sinara-hw/HVSUP_ISOL/MECH/coil_cover/coil_cover.stp

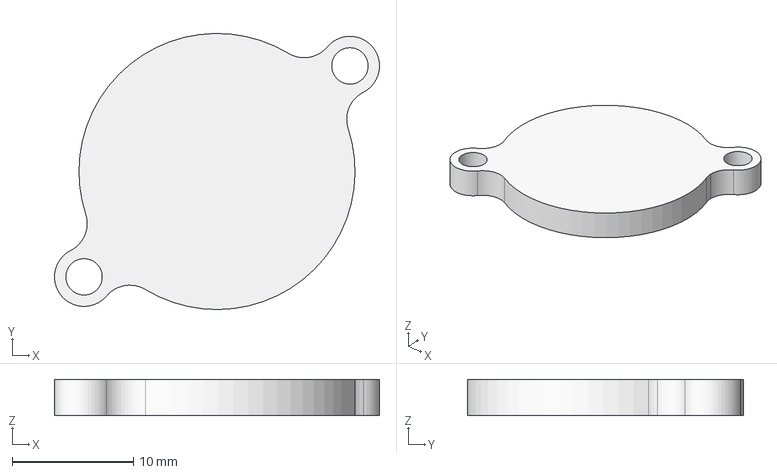
[picture p1: CAD file, 2024-01-04]
MECH/coil_cover/coil_cover.stp
26.8 x 22.7 x 3.00 mm
