sinara-hw/HVSUP_ISOL/MECH/Cover/Cover.stp

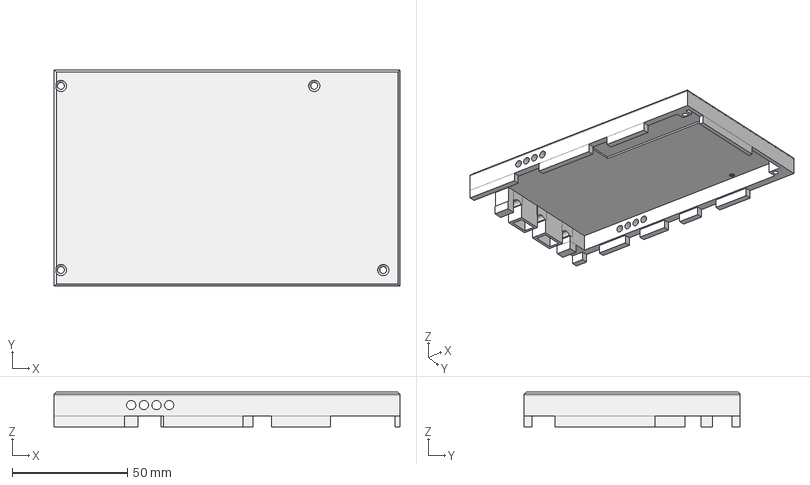
[picture p2: CAD file, 2023-11-23]
MECH/Cover/Cover.stp
150.3 x 94.0 x 15.2 mm
