sinara-hw/HVSUP_ISOL/(list of files, drawings)

Other design files:
Common_HVPSU_ISOL/Common_HVPSU_ISOL.PCBDOC
Common_HVPSU_ISOL/Common_HVPSU_ISOL.schdoc
Common_HVPSU_ISOL/Common_HVSUP_ISOL.PrjPCB
Common_HVPSU_ISOL_6k/Common_HVPSU_ISOL.schdoc
Common_HVPSU_ISOL_6k/Common_HVPSU_ISOL_6W.PCBDOC
Common_HVPSU_ISOL_6k/Common_HVSUP_ISOL_6W.PrjPCB
HV_Module.PCBDOC
HV_Module_2W/ADC_DAC.SchDoc
HV_Module_2W/HV_Module.schdoc
HV_Module_2W/HV_Module_2W.PrjPCB
HV_Module_2W/HV_Module_2W.schdoc
HV_Module_2W/HV_PWR_STAGE.SchDoc
HV_Module_2W/Isolators_HV.SchDoc
HV_Module_2W/LED_indicators.SchDoc
HV_Module_2W/Supply_5V_ISOL.SchDoc
HV_Module_6W/ADC_DAC_6W.SchDoc
HV_Module_6W/HV_Module_6W.PrjPCB
HV_Module_6W/HV_Module_6W.schdoc
HV_Module_6W/HV_PWR_STAGE_6W.SchDoc
HV_Module_6W/Isolators_HV_6W.SchDoc
HV_Module_6W/LED_indicators_6W.SchDoc
HV_Module_6W/Supply_12V_ISOL.SchDoc
HVSUP_ISOL.PCBDOC
HVSUP_ISOL_Mainboard/DIOT_Connectors.SchDoc
HVSUP_ISOL_Mainboard/EEM_connector.SchDoc
HVSUP_ISOL_Mainboard/HVPSU_ISOL_Mainboard.PrjPCB
HVSUP_ISOL_Mainboard/HVSUP_ISOL_Mainboard.schdoc
HVSUP_ISOL_Mainboard/Supply_HV_ISOL.SchDoc
MECH/Panel/Panel_HVSUP_ISOL.PcbDoc
