sinara-hw/HVSUP_ISOL/(threads)

Thread 1 (2022-02-06):

new HV supply

gkasprow, 2022-02-06:
We need a modular HV supply for the GEM detector.
The supply must be modular, floating, and cascadable.
Depending on the GEM detector, we need 7 to 12 channels, mostly negative polarity.
We need current and voltage monitoring and fast arc detection.
Typical configuration (triple GEM detector) requires 7 channels cascaded up to 5kV.
The design must be simple, use standard mechanical parts. The only custom part will be 3D printed cover.
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

gkasprow, 2022-02-21:
Placement done
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

gkasprow, 2022-02-21:
DIOT version
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

Closed 2023-11-18.

Thread 2 (2022-03-11):

power sequencing

gkasprow, 2022-03-11:
@filipswit cf https://github.com/sinara-hw/SiLPA/issues/2

Closed 2022-05-20.

Thread 3 (2022-04-10):

schematic review

filipswit, 2022-04-10:
**HV Module**
- [x] Shorted +Vin to -Vin
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

- [x] It is recommended to place 1uF **and 100nF** in parallel beside isolation links
- [x] P3V3 shorted with P3V3p through IC27 and IC28
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

- [x] Missing decap at IC27
- [x] MAX1329: `CAVDD and CDVDD filter capacitor can be a low-ESR tantalum or may need to be a combination of a small ceramic and a larger tantalum capacitor
` It would be probabbly good to change one 10uf ceramic to tantalum

- [x] Missing P3V3 rail

**HVPSU ISOL**

- [x] Useless test point for P3V3A
- [x] Missing ESD strip
- [x] Separate power connections from CPCIS and EEM parts

tprzywoz, 2022-04-27:
- [ ] MAX1329 RSTs pins are push-pull when configured as interrupt outputs so we need to separate them.

filipswit, 2022-05-01:
Thanks @tprzywoz, I've added 2 mos keys.

Closed 2022-05-20.

Thread 4 (2022-05-19):

parts availability

gkasprow, 2022-05-19:
https://github.com/sinara-hw/Kasli/issues/97

filipswit, 2022-05-20:
There is 24AA025E48-I/SN already, with same footprint.

gkasprow, 2022-05-20:
24AA025E48 has 16byte page while 24AA02E48 has 8byte page.

Closed 2022-05-20.

Thread 5 (2022-07-12):

mgf issues

gkasprow, 2022-07-12:
add alt footprint for opamps : OPA2320 in 10VSSOP

gkasprow, 2022-07-13:
alt PN for opamp has wrong package

gkasprow, 2022-10-06:
missin lightguides in the BOM
PLP2-1200

gkasprow, 2023-07-26:
resistor conflict with plastic cover

Closed 2023-11-18.

Thread 10 (2023-05-12):

IC14B wrong gain value

tprzywoz, 2023-05-12:
R33 15k with R28 10k = 2.5 V/V. We need 5 V/V to reach 0...2.5V.

tprzywoz, 2023-05-12:
And I think that R79 value should be R33||R28 not R28

gkasprow, 2023-05-12:
Indeed

tprzywoz, 2023-11-29:
R33 divided by R28 should be 4, not 3 and as a consequence R79 will be different

Closed 2024-01-03.

Thread 8 (2023-05-12):

User can not switch PSU OFF

tprzywoz, 2023-05-12:
PSU_EN has 1.26 V when LVDS4 is set to low. There is voltage divider between P3V3MP (LED + 220 Ohm) + series 1k resistor R17 at LVDS revceiver output.

gkasprow, 2023-05-12:
right. We need to add another transistor to drive LED. Temporairly you can swap these 1k and 220R resistors

gkasprow, 2023-11-18:
added another transistor
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

Closed 2023-11-18.

Thread 9 (2023-05-12):

Overtemp LED

tprzywoz, 2023-05-12:
Even if we fix PSU_EN problem #8, LD7 is on both when the temperature is exceeded and when PSU_EN is turned off manually. We already have PSU_EN led, so LD7 should only indicate overtemp.

gkasprow, 2023-11-18:
fixed with a dedicated transistor
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

Closed 2023-11-18.

Thread 11 (2023-06-20):

Add HV nets to HV net class and change clearance_HV rule

tprzywoz, 2023-06-20:
Now there is 1 mm space between C28 HV pad and R60. At max declared voltage, there is 1kV. HV nets should be added to HV net class and clearance rule should be increased (Saturn suggests 2.5 mm for 500 V).

Closed 2023-11-18.

Thread 12 (2023-10-03):

Oscillations at HVDC converter ctrl pin.

tprzywoz, 2023-10-03:
Add capacitor (100 nF) on 5 pin of IC9. There is crosstalk from internal oscillator on ctrl pin. At higher output voltage levels, it is strong enough to keep converter switched on and we lose control.

gkasprow, 2023-11-18:
it's Royer oscillator base signa. That's why we observe oscillations. Added 100nF capacitor

Closed 2023-11-18.

Thread 13 (2023-10-10):

IC11 PS

tprzywoz, 2023-10-10:
IC11 has to be connected to negative power supply, -0.5 V is enough. Without that internal oscillations at CTRL pin of IC9 keep converter switched on even with capacitor #12 (thanks to cap there is option to switch it off by ENABLE signal but no by DAC control signal).

gkasprow, 2023-11-18:
added -3.3V rail supply, opamps replaced with ADA4510 that can work with >5V

Closed 2023-11-18.

Thread 14 (2023-11-15):

cover mounting holes

gkasprow, 2023-11-15:
add 4 2.5mm mountig holes for plastic cover

gkasprow, 2023-11-18:
they are already - the same holes that fix the module

Closed 2023-11-18.

Thread 15 (2023-11-16):

increase length of the HV module

gkasprow, 2023-11-16:
Make the HV module longer by 20mm, move the connector and mounting holes on the baseboard. Increase the distances between HV resistors

Closed 2023-11-18.
