sinara-hw/HVSUP_ISOL/(commit log)

2022-05-01 Schematics corrections
    [ADC_DAC.SchDoc, Common_HVPSU_ISOL.PCBDOC, Common_HVPSU_ISOL.schdoc, Common_HVSUP_ISOL.PrjPCB, DIOT_Connectors.SchDoc, EEM_connector.SchDoc, HVPSU_ISOL.PrjPCB, HVSUP_ISOL.schdoc]
2022-05-20 pcb v1.0
    [Common_HVPSU_ISOL.PCBDOC, Common_HVSUP_ISOL.PrjPCB, EEM_connector.SchDoc, HVPSU_ISOL.PrjPCB, HVSUP_ISOL.schdoc, HV_Module.PrjPCB, HV_Module.schdoc, HV_PWR_STAGE.SchDoc]
2022-05-21 changed eeprom PN. v1.0rc1
    [EEM_connector.SchDoc, HVPSU_ISOL.PrjPCB]
2022-06-01 pcb v1.0rc2
2023-11-23 added 6W version, 2W version with issues fixed
    [ADC_DAC.SchDoc, ADC_DAC_6W.SchDoc, Common_HVPSU_ISOL.PCBDOC, Common_HVPSU_ISOL.schdoc, Common_HVPSU_ISOL_6W.PCBDOC, Common_HVSUP_ISOL.PrjPCB, Common_HVSUP_ISOL_6W.PrjPCB, Copy of HV_PWR_STAGE.SchDoc]
2024-01-04 v1.1rc2; cosmetics and new output job files
    [ADC_DAC.SchDoc, ADC_DAC_6W.SchDoc, Common_HVSUP_ISOL.PrjPCB, Common_HVSUP_ISOL_6W.PrjPCB, DIOT_Connectors.SchDoc, EEM_connector.SchDoc, HVPSU_ISOL.PrjPCB, HVPSU_ISOL_Mainboard.PrjPCB]
